hvitis/LanternHouse/docs/prices.csv

offer_id | title | format | grade | thickness_mm | width_mm | length_mm | size_cm | pack_qty | area_sheet_m2 | total_area_m2 | price_pln | price_with_shipping_pln | price_per_sheet_pln | price_per_m2_pln | price_with_shipping_per_m2_pln | rating | reviews_count | bought_count | smart | promoted
1 | SKLEJKA DESKA 3mm FORMATKA DO LASERA CNC GRAWER 300x100mm 1 SZT KLASA 2 | 10x30cm | Klasa 2 | 3.0 | 100 | 300 | 10.0x30.0 | 1 | 0.0300 | 0.0300 | 1.60 | 12.09 | 1.60 | 53.33 | 403.00 | 4.97 | 32 | 11 | Tak | Nie
2 | SKLEJKA DESKA 3mm FORMATKA DO LASERA CNC GRAWER 300x100mm 5 SZT KLASA 2 | 10x30cm | Klasa 2 | 3.0 | 100 | 300 | 10.0x30.0 | 5 | 0.0300 | 0.1500 | 8.02 | 18.51 | 1.60 | 53.47 | 123.40 | 4.97 | 32 | 11 | Tak | Nie
3 | SKLEJKA DESKA 3mm FORMATKA DO LASERA CNC GRAWER 300x100mm 10 SZT KLASA 2 | 10x30cm | Klasa 2 | 3.0 | 100 | 300 | 10.0x30.0 | 10 | 0.0300 | 0.3000 | 16.05 | 26.54 | 1.60 | 53.50 | 88.47 | 4.97 | 32 | 11 | Tak | Nie
4 | SKLEJKA DESKA 3mm FORMATKA DO LASERA CNC GRAWER 300x100mm 20 SZT KLASA 2 | 10x30cm | Klasa 2 | 3.0 | 100 | 300 | 10.0x30.0 | 20 | 0.0300 | 0.6000 | 32.09 | 42.58 | 1.60 | 53.48 | 70.97 | 4.97 | 32 | 11 | Tak | Nie
5 | SKLEJKA DESKA 3mm FORMATKA DO LASERA CNC GRAWER 300x100mm 50 SZT KLASA 2 | 10x30cm | Klasa 2 | 3.0 | 100 | 300 | 10.0x30.0 | 50 | 0.0300 | 1.5000 | 79.70 | 90.19 | 1.59 | 53.13 | 60.13 | 4.97 | 32 | 11 | Tak | Nie
6 | SKLEJKA DESKA A5 3mm FORMATKA DO LASERA CNC GRAWER 148x210mm 1 SZT KLASA 2 | A5 | Klasa 2 | 3.0 | 148 | 210 | 14.8x21.0 | 1 | 0.0311 | 0.0311 | 1.60 | 12.09 | 1.60 | 51.48 | 389.00 | 4.93 | 56 | 28 | Tak | Nie
7 | SKLEJKA DESKA A5 3mm FORMATKA DO LASERA CNC GRAWER 148x210mm 5 SZT KLASA 2 | A5 | Klasa 2 | 3.0 | 148 | 210 | 14.8x21.0 | 5 | 0.0311 | 0.1554 | 8.02 | 18.51 | 1.60 | 51.61 | 119.11 | 4.93 | 112 | 56 | Tak | Nie
8 | SKLEJKA DESKA A5 3mm FORMATKA DO LASERA CNC GRAWER 148x210mm 10 SZT KLASA 2 | A5 | Klasa 2 | 3.0 | 148 | 210 | 14.8x21.0 | 10 | 0.0311 | 0.3108 | 16.04 | 26.53 | 1.60 | 51.61 | 85.36 | 4.93 | 112 | 56 | Tak | Nie
9 | SKLEJKA DESKA A5 3mm FORMATKA DO LASERA CNC GRAWER 148x210mm 20 SZT KLASA 2 | A5 | Klasa 2 | 3.0 | 148 | 210 | 14.8x21.0 | 20 | 0.0311 | 0.6216 | 32.05 | 42.54 | 1.60 | 51.56 | 68.44 | 4.93 | 57 | 31 | Tak | Nie
10 | SKLEJKA DESKA A5 3mm FORMATKA DO LASERA CNC GRAWER 148x210mm 50 SZT KLASA 2 | A5 | Klasa 2 | 3.0 | 148 | 210 | 14.8x21.0 | 50 | 0.0311 | 1.5540 | 79.70 | 90.19 | 1.59 | 51.29 | 58.04 | 4.93 | 112 | 56 | Tak | Nie
11 | SKLEJKA DESKA A4 3mm FORMATKA DO LASERA CNC GRAWER 210x297mm 1 SZT KLASA 1 | A4 | Klasa 1 | 3.0 | 210 | 297 | 21.0x29.7 | 1 | 0.0624 | 0.0624 | 3.21 | 13.70 | 3.21 | 51.47 | 219.66 | 4.73 | 548 | 356 | Tak | Tak
12 | SKLEJKA DESKA A4 3mm FORMATKA DO LASERA CNC GRAWER 210x297mm 5 SZT KLASA 1 | A4 | Klasa 1 | 3.0 | 210 | 297 | 21.0x29.7 | 5 | 0.0624 | 0.3119 | 16.09 | 26.58 | 3.22 | 51.60 | 85.23 | 4.73 | 548 | 356 | Tak | Nie
13 | SKLEJKA DESKA A4 3mm FORMATKA DO LASERA CNC GRAWER 210x297mm 10 SZT KLASA 1 | A4 | Klasa 1 | 3.0 | 210 | 297 | 21.0x29.7 | 10 | 0.0624 | 0.6237 | 32.19 | 42.68 | 3.22 | 51.61 | 68.43 | 4.73 | 548 | 356 | Tak | Nie
14 | SKLEJKA DESKA A4 3mm FORMATKA DO LASERA CNC GRAWER 210x297mm 20 SZT KLASA 1 | A4 | Klasa 1 | 3.0 | 210 | 297 | 21.0x29.7 | 20 | 0.0624 | 1.2474 | 64.39 | 74.88 | 3.22 | 51.62 | 60.03 | 4.73 | 291 | 187 | Tak | Nie
15 | SKLEJKA DESKA A4 3mm FORMATKA DO LASERA CNC GRAWER 210x297mm 50 SZT KLASA 1 | A4 | Klasa 1 | 3.0 | 210 | 297 | 21.0x29.7 | 50 | 0.0624 | 3.1185 | 159.58 | 170.07 | 3.19 | 51.17 | 54.54 | 4.73 | 275 | 184 | Tak | Nie
16 | SKLEJKA DESKA A4 3mm FORMATKA DO LASERA CNC GRAWER 210x297mm 1 SZT KLASA 2 | A4 | Klasa 2 | 3.0 | 210 | 297 | 21.0x29.7 | 1 | 0.0624 | 0.0624 | 3.12 | 13.61 | 3.12 | 50.02 | 218.21 | 4.87 | 106 | 46 | Tak | Tak
17 | SKLEJKA DESKA A4 3mm FORMATKA DO LASERA CNC GRAWER 210x297mm 5 SZT KLASA 2 | A4 | Klasa 2 | 3.0 | 210 | 297 | 21.0x29.7 | 5 | 0.0624 | 0.3119 | 15.62 | 26.11 | 3.12 | 50.09 | 83.73 | 4.86 | 55 | 24 | Tak | Nie
18 | SKLEJKA DESKA A4 3mm FORMATKA DO LASERA CNC GRAWER 210x297mm 10 SZT KLASA 2 | A4 | Klasa 2 | 3.0 | 210 | 297 | 21.0x29.7 | 10 | 0.0624 | 0.6237 | 31.25 | 41.74 | 3.12 | 50.10 | 66.92 | 4.87 | 54 | 28 | Tak | Nie
19 | SKLEJKA DESKA A4 3mm FORMATKA DO LASERA CNC GRAWER 210x297mm 20 SZT KLASA 2 | A4 | Klasa 2 | 3.0 | 210 | 297 | 21.0x29.7 | 20 | 0.0624 | 1.2474 | 62.50 | 72.99 | 3.12 | 50.10 | 58.51 | 4.87 | 54 | 26 | Tak | Nie
20 | SKLEJKA DESKA A4 3mm FORMATKA DO LASERA CNC GRAWER 210x297mm 50 SZT KLASA 2 | A4 | Klasa 2 | 3.0 | 210 | 297 | 21.0x29.7 | 50 | 0.0624 | 3.1185 | 156.27 | 166.76 | 3.13 | 50.11 | 53.47 | 4.87 | 54 | 24 | Tak | Nie
21 | SKLEJKA DESKA 3mm FORMATKA DO LASERA CNC GRAWER 40x30cm KLASA 1 - 1 SZTUKA | 30x40cm | Klasa 1 | 3.0 | 300 | 400 | 30.0x40.0 | 1 | 0.1200 | 0.1200 | 5.97 | 16.46 | 5.97 | 49.75 | 137.17 | 4.65 | 83 | 50 | Tak | Nie
22 | SKLEJKA DESKA 3mm FORMATKA DO LASERA CNC GRAWER 40x30cm KLASA 1 - 5 SZTUK | 30x40cm | Klasa 1 | 3.0 | 300 | 400 | 30.0x40.0 | 5 | 0.1200 | 0.6000 | 29.87 | 40.36 | 5.97 | 49.78 | 67.27 | 4.65 | 83 | 50 | Tak | Nie
23 | SKLEJKA DESKA 3mm FORMATKA DO LASERA CNC GRAWER 40x30cm KLASA 1 - 10 SZTUK | 30x40cm | Klasa 1 | 3.0 | 300 | 400 | 30.0x40.0 | 10 | 0.1200 | 1.2000 | 59.74 | 70.23 | 5.97 | 49.78 | 58.53 | 4.56 | 163 | 122 | Tak | Nie
24 | SKLEJKA DESKA 3mm FORMATKA DO LASERA CNC GRAWER 40x30cm KLASA 1 - 20 SZTUK | 30x40cm | Klasa 1 | 3.0 | 300 | 400 | 30.0x40.0 | 20 | 0.1200 | 2.4000 | 118.65 | 129.14 | 5.93 | 49.44 | 53.81 | 4.65 | 83 | 50 | Tak | Nie
25 | SKLEJKA DESKA 3mm FORMATKA DO LASERA CNC GRAWER 40x30cm KLASA 1 - 50 SZTUK | 30x40cm | Klasa 1 | 3.0 | 300 | 400 | 30.0x40.0 | 50 | 0.1200 | 6.0000 | 294.48 | 304.97 | 5.89 | 49.08 | 50.83 | 4.65 | 83 | 50 | Tak | Nie
26 | SKLEJKA DESKA 3mm FORMATKA DO LASERA CNC GRAWER 40x30cm KLASA 2 - 1 SZTUKA | 30x40cm | Klasa 2 | 3.0 | 300 | 400 | 30.0x40.0 | 1 | 0.1200 | 0.1200 | 5.78 | 16.27 | 5.78 | 48.17 | 135.58 | 4.84 | 25 | 7 | Tak | Nie
27 | SKLEJKA DESKA 3mm FORMATKA DO LASERA CNC GRAWER 40x30cm KLASA 2 - 5 SZTUK | 30x40cm | Klasa 2 | 3.0 | 300 | 400 | 30.0x40.0 | 5 | 0.1200 | 0.6000 | 28.48 | 38.97 | 5.70 | 47.47 | 64.95 | 4.84 | 25 | 7 | Tak | Nie
28 | SKLEJKA DESKA 3mm FORMATKA DO LASERA CNC GRAWER 40x30cm KLASA 2 - 10 SZTUK | 30x40cm | Klasa 2 | 3.0 | 300 | 400 | 30.0x40.0 | 10 | 0.1200 | 1.2000 | 56.90 | 67.39 | 5.69 | 47.42 | 56.16 | 4.84 | 25 | 7 | Tak | Nie
29 | SKLEJKA DESKA 3mm FORMATKA DO LASERA CNC GRAWER 40x30cm KLASA 2 - 20 SZTUK | 30x40cm | Klasa 2 | 3.0 | 300 | 400 | 30.0x40.0 | 20 | 0.1200 | 2.4000 | 109.15 | 119.64 | 5.46 | 45.48 | 49.85 | 4.84 | 25 | 7 | Tak | Nie
30 | SKLEJKA DESKA 3mm FORMATKA DO LASERA CNC GRAWER 40x30cm KLASA 2 - 50 SZTUK | 30x40cm | Klasa 2 | 3.0 | 300 | 400 | 30.0x40.0 | 50 | 0.1200 | 6.0000 | 275.49 | 285.98 | 5.51 | 45.91 | 47.66 | 4.84 | 25 | 7 | Tak | Nie
31 | SKLEJKA DESKA 3mm FORMATKA DO LASERA CNC GRAWER 30x50cm KLASA 1 - 1 SZTUKA | 30x50cm | Klasa 1 | 3.0 | 300 | 500 | 30.0x50.0 | 1 | 0.1500 | 0.1500 | 7.30 | 17.79 | 7.30 | 48.67 | 118.60 | 4.85 | 33 | 29 | Tak | Nie
32 | SKLEJKA DESKA 3mm FORMATKA DO LASERA CNC GRAWER 30x50cm KLASA 1 - 5 SZTUK | 30x50cm | Klasa 1 | 3.0 | 300 | 500 | 30.0x50.0 | 5 | 0.1500 | 0.7500 | 36.52 | 47.01 | 7.30 | 48.69 | 62.68 | 4.85 | 33 | 29 | Tak | Nie
33 | SKLEJKA DESKA 3mm FORMATKA DO LASERA CNC GRAWER 30x50cm KLASA 1 - 10 SZTUK | 30x50cm | Klasa 1 | 3.0 | 300 | 500 | 30.0x50.0 | 10 | 0.1500 | 1.5000 | 73.04 | 83.53 | 7.30 | 48.69 | 55.69 | 4.85 | 33 | 29 | Tak | Nie
34 | SKLEJKA DESKA 3mm FORMATKA DO LASERA CNC GRAWER 30x50cm KLASA 1 - 20 SZTUK | 30x50cm | Klasa 1 | 3.0 | 300 | 500 | 30.0x50.0 | 20 | 0.1500 | 3.0000 | 145.25 | 155.74 | 7.26 | 48.42 | 51.91 | 4.81 | 32 | 28 | Tak | Nie
35 | SKLEJKA DESKA 3mm FORMATKA DO LASERA CNC GRAWER 30x50cm KLASA 1 - 50 SZTUK | 30x50cm | Klasa 1 | 3.0 | 300 | 500 | 30.0x50.0 | 50 | 0.1500 | 7.5000 | 364.79 | 375.28 | 7.30 | 48.64 | 50.04 | 4.83 | 30 | 25 | Tak | Nie
36 | SKLEJKA DESKA 3mm FORMATKA DO LASERA CNC GRAWER 30x50cm KLASA 2 - 1 SZTUKA | 30x50cm | Klasa 2 | 3.0 | 300 | 500 | 30.0x50.0 | 1 | 0.1500 | 0.1500 | 7.20 | 17.69 | 7.20 | 48.00 | 117.93 | 5.00 | 9 | 2 | Tak | Nie
37 | SKLEJKA DESKA 3mm FORMATKA DO LASERA CNC GRAWER 30x50cm KLASA 2 - 5 SZTUK | 30x50cm | Klasa 2 | 3.0 | 300 | 500 | 30.0x50.0 | 5 | 0.1500 | 0.7500 | 36.04 | 46.53 | 7.21 | 48.05 | 62.04 | 5.00 | 9 | 2 | Tak | Nie
38 | SKLEJKA DESKA 3mm FORMATKA DO LASERA CNC GRAWER 30x50cm KLASA 2 - 10 SZTUK | 30x50cm | Klasa 2 | 3.0 | 300 | 500 | 30.0x50.0 | 10 | 0.1500 | 1.5000 | 72.09 | 82.58 | 7.21 | 48.06 | 55.05 | 5.00 | 9 | 2 | Tak | Nie
39 | SKLEJKA DESKA 3mm FORMATKA DO LASERA CNC GRAWER 30x50cm KLASA 2 - 20 SZTUK | 30x50cm | Klasa 2 | 3.0 | 300 | 500 | 30.0x50.0 | 20 | 0.1500 | 3.0000 | 142.48 | 152.97 | 7.12 | 47.49 | 50.99 | 5.00 | 9 | 2 | Tak | Nie
40 | SKLEJKA DESKA 3mm FORMATKA DO LASERA CNC GRAWER 30x50cm KLASA 2 - 50 SZTUK | 30x50cm | Klasa 2 | 3.0 | 300 | 500 | 30.0x50.0 | 50 | 0.1500 | 7.5000 | 350.54 | 361.03 | 7.01 | 46.74 | 48.14 | 5.00 | 9 | 2 | Tak | Nie
41 | SKLEJKA 3mm FORMATKA DO LASERA CNC GRAWER 30x60cm 300x600mm KLASA 1 1 SZT | 30x60cm | Klasa 1 | 3.0 | 300 | 600 | 30.0x60.0 | 1 | 0.1800 | 0.1800 | 8.91 | 19.40 | 8.91 | 49.50 | 107.78 | 4.95 | 44 | 52 | Tak | Nie
42 | SKLEJKA DESKA 3mm FORMATKA DO LASERA CNC GRAWER 30x60cm KLASA 1 - 5 SZTUK | 30x60cm | Klasa 1 | 3.0 | 300 | 600 | 30.0x60.0 | 5 | 0.1800 | 0.9000 | 47.41 | 57.90 | 9.48 | 52.68 | 64.33 | 4.80 | 25 | 26 | Tak | Nie
43 | SKLEJKA DESKA 3mm FORMATKA DO LASERA CNC GRAWER 30x60cm KLASA 1 - 10 SZTUK | 30x60cm | Klasa 1 | 3.0 | 300 | 600 | 30.0x60.0 | 10 | 0.1800 | 1.8000 | 89.19 | 99.68 | 8.92 | 49.55 | 55.38 | 4.89 | 27 | 29 | Tak | Nie
44 | SKLEJKA DESKA 3mm FORMATKA DO LASERA CNC GRAWER 30x60cm KLASA 1 - 20 SZTUK | 30x60cm | Klasa 1 | 3.0 | 300 | 600 | 30.0x60.0 | 20 | 0.1800 | 3.6000 | 178.11 | 188.60 | 8.91 | 49.48 | 52.39 | 4.95 | 22 | 28 | Tak | Nie
45 | SKLEJKA DESKA 3mm FORMATKA DO LASERA CNC GRAWER 30x60cm KLASA 1 - 50 SZTUK | 30x60cm | Klasa 1 | 3.0 | 300 | 600 | 30.0x60.0 | 50 | 0.1800 | 9.0000 | 436.04 | 446.53 | 8.72 | 48.45 | 49.61 | 4.95 | 22 | 26 | Tak | Nie
46 | SKLEJKA DESKA 3mm FORMATKA DO LASERA CNC GRAWER 30x60cm KLASA 2 - 1 SZTUKA | 30x60cm | Klasa 2 | 3.0 | 300 | 600 | 30.0x60.0 | 1 | 0.1800 | 0.1800 | 8.68 | 19.17 | 8.68 | 48.22 | 106.50 | 5.00 | 7 | 2 | Tak | Nie
47 | SKLEJKA DESKA 3mm FORMATKA DO LASERA CNC GRAWER 30x60cm KLASA 2 - 5 SZTUK | 30x60cm | Klasa 2 | 3.0 | 300 | 600 | 30.0x60.0 | 5 | 0.1800 | 0.9000 | 47.41 | 57.90 | 9.48 | 52.68 | 64.33 | 5.00 | 7 | 2 | Tak | Nie
48 | SKLEJKA DESKA 3mm FORMATKA DO LASERA CNC GRAWER 30x60cm KLASA 2 - 10 SZTUK | 30x60cm | Klasa 2 | 3.0 | 300 | 600 | 30.0x60.0 | 10 | 0.1800 | 1.8000 | 86.91 | 97.40 | 8.69 | 48.28 | 54.11 | 5.00 | 7 | 2 | Tak | Nie
49 | SKLEJKA DESKA 3mm FORMATKA DO LASERA CNC GRAWER 30x60cm KLASA 2 - 20 SZTUK | 30x60cm | Klasa 2 | 3.0 | 300 | 600 | 30.0x60.0 | 20 | 0.1800 | 3.6000 | 170.98 | 181.47 | 8.55 | 47.49 | 50.41 | 5.00 | 7 | 1 | Tak | Nie
50 | SKLEJKA DESKA 3mm FORMATKA DO LASERA CNC GRAWER 30x60cm KLASA 2 - 50 SZTUK | 30x60cm | Klasa 2 | 3.0 | 300 | 600 | 30.0x60.0 | 50 | 0.1800 | 9.0000 | 417.04 | 427.53 | 8.34 | 46.34 | 47.50 | 5.00 | 7 | 2 | Tak | Nie
51 | SKLEJKA DESKA 3mm FORMATKA DO LASERA CNC GRAWER 600x400mm KLASA 1 -1 SZTUKA | 40x60cm | Klasa 1 | 3.0 | 400 | 600 | 40.0x60.0 | 1 | 0.2400 | 0.2400 | 13.76 | 24.25 | 13.76 | 57.33 | 101.04 | 4.53 | 144 | 54 | Tak | Nie
52 | SKLEJKA DESKA 3mm FORMATKA DO LASERA CNC GRAWER 600x400mm KLASA 1 - 5 SZTUK | 40x60cm | Klasa 1 | 3.0 | 400 | 600 | 40.0x60.0 | 5 | 0.2400 | 1.2000 | 68.82 | 79.31 | 13.76 | 57.35 | 66.09 | 4.53 | 76 | 31 | Tak | Nie
53 | SKLEJKA DESKA 3mm FORMATKA DO LASERA CNC GRAWER 600x400mm KLASA 1 -10 SZTUK | 40x60cm | Klasa 1 | 3.0 | 400 | 600 | 40.0x60.0 | 10 | 0.2400 | 2.4000 | 137.65 | 148.14 | 13.77 | 57.35 | 61.72 | 4.51 | 77 | 33 | Tak | Nie
54 | SKLEJKA DESKA 3mm FORMATKA DO LASERA CNC GRAWER 600x400mm KLASA 1 -20 SZTUK | 40x60cm | Klasa 1 | 3.0 | 400 | 600 | 40.0x60.0 | 20 | 0.2400 | 4.8000 | 275.40 | 285.89 | 13.77 | 57.38 | 59.56 | 4.53 | 74 | 31 | Tak | Nie
55 | SKLEJKA DESKA 3mm FORMATKA DO LASERA CNC GRAWER 600x400mm KLASA 1 -50 SZTUK | 40x60cm | Klasa 1 | 3.0 | 400 | 600 | 40.0x60.0 | 50 | 0.2400 | 12.0000 | 683.90 | 698.89 | 13.68 | 56.99 | 58.24 | 4.53 | 72 | 28 | Tak | Nie
56 | SKLEJKA 3mm FORMATKA DO LASERA CNC GRAWER 60x40cm 600x400mm KLASA 2 - 1 SZT | 40x60cm | Klasa 2 | 3.0 | 400 | 600 | 40.0x60.0 | 1 | 0.2400 | 0.2400 | 13.56 | 24.05 | 13.56 | 56.50 | 100.21 | 4.74 | 154 | 20 | Tak | Tak
57 | SKLEJKA 3mm FORMATKA DO LASERA CNC GRAWER 60x40cm 600x400mm KLASA 2 - 5 SZT | 40x60cm | Klasa 2 | 3.0 | 400 | 600 | 40.0x60.0 | 5 | 0.2400 | 1.2000 | 66.48 | 76.97 | 13.30 | 55.40 | 64.14 | 4.75 | 79 | 11 | Tak | Nie
58 | SKLEJKA 3mm FORMATKA DO LASERA CNC GRAWER 60x40cm 600x400mm KLASA 2 -10 SZT | 40x60cm | Klasa 2 | 3.0 | 400 | 600 | 40.0x60.0 | 10 | 0.2400 | 2.4000 | 132.98 | 143.47 | 13.30 | 55.41 | 59.78 | 4.75 | 81 | 11 | Tak | Nie
59 | SKLEJKA 3mm FORMATKA DO LASERA CNC GRAWER 60x40cm 600x400mm KLASA 2 -20 SZT | 40x60cm | Klasa 2 | 3.0 | 400 | 600 | 40.0x60.0 | 20 | 0.2400 | 4.8000 | 264.99 | 275.48 | 13.25 | 55.21 | 57.39 | 4.74 | 77 | 10 | Tak | Nie
60 | SKLEJKA 3mm FORMATKA DO LASERA CNC GRAWER 60x40cm 600x400mm KLASA 2 -50 SZT | 40x60cm | Klasa 2 | 3.0 | 400 | 600 | 40.0x60.0 | 50 | 0.2400 | 12.0000 | 664.04 | 679.03 | 13.28 | 55.34 | 56.59 | 4.74 | 77 | 11 | Tak | Nie
61 | SKLEJKA DESKA 3mm FORMATKA DO LASERA CNC GRAWER 50x50cm KLASA 1 - 1 SZTUKA | 50x50cm | Klasa 1 | 3.0 | 500 | 500 | 50.0x50.0 | 1 | 0.2500 | 0.2500 | 12.33 | 27.32 | 12.33 | 49.32 | 109.28 | 4.67 | 30 | 8 | Tak | Nie
62 | SKLEJKA DESKA 3mm FORMATKA DO LASERA CNC GRAWER 50x50cm KLASA 1 - 5 SZTUK | 50x50cm | Klasa 1 | 3.0 | 500 | 500 | 50.0x50.0 | 5 | 0.2500 | 1.2500 | 61.75 | 76.74 | 12.35 | 49.40 | 61.39 | 4.67 | 30 | 8 | Tak | Nie
63 | SKLEJKA DESKA 3mm FORMATKA DO LASERA CNC GRAWER 50x50cm KLASA 1 - 10 SZTUK | 50x50cm | Klasa 1 | 3.0 | 500 | 500 | 50.0x50.0 | 10 | 0.2500 | 2.5000 | 122.53 | 137.52 | 12.25 | 49.01 | 55.01 | 4.67 | 30 | 8 | Tak | Nie
64 | SKLEJKA DESKA 3mm FORMATKA DO LASERA CNC GRAWER 50x50cm KLASA 2 - 1 SZTUKA | 50x50cm | Klasa 2 | 3.0 | 500 | 500 | 50.0x50.0 | 1 | 0.2500 | 0.2500 | 11.95 | 26.94 | 11.95 | 47.80 | 107.76 | 4.77 | 26 | 8 | Tak | Nie
65 | SKLEJKA DESKA 3mm FORMATKA DO LASERA CNC GRAWER 50x50cm KLASA 2 - 5 SZTUK | 50x50cm | Klasa 2 | 3.0 | 500 | 500 | 50.0x50.0 | 5 | 0.2500 | 1.2500 | 59.79 | 74.78 | 11.96 | 47.83 | 59.82 | 4.77 | 26 | 8 | Tak | Nie
66 | SKLEJKA DESKA 3mm FORMATKA DO LASERA CNC GRAWER 50x50cm KLASA 2 - 10 SZTUK | 50x50cm | Klasa 2 | 3.0 | 500 | 500 | 50.0x50.0 | 10 | 0.2500 | 2.5000 | 119.49 | 134.48 | 11.95 | 47.80 | 53.79 | 4.77 | 26 | 8 | Tak | Nie
67 | SKLEJKA DESKA 3mm FORMATKA DO LASERA CNC GRAWER 50x50cm KLASA 2 - 20 SZTUK | 50x50cm | Klasa 2 | 3.0 | 500 | 500 | 50.0x50.0 | 20 | 0.2500 | 5.0000 | 237.48 | 252.47 | 11.87 | 47.50 | 50.49 | 4.77 | 26 | 8 | Tak | Nie
68 | SKLEJKA DESKA 3mm FORMATKA DO LASERA CNC GRAWER 50x50cm KLASA 2 - 50 SZTUK | 50x50cm | Klasa 2 | 3.0 | 500 | 500 | 50.0x50.0 | 50 | 0.2500 | 12.5000 | 588.04 | 603.03 | 11.76 | 47.04 | 48.24 | 4.77 | 26 | 8 | Tak | Nie
69 | SKLEJKA DESKA 3mm FORMATKA DO LASERA CNC GRAWER 760x380mm 1 SZTUKA KLASA 2 | 38x76cm | Klasa 2 | 3.0 | 380 | 760 | 38.0x76.0 | 1 | 0.2888 | 0.2888 | 13.28 | 28.27 | 13.28 | 45.98 | 97.89 | 5.00 | 2 | 1 | Tak | Nie
70 | SKLEJKA DESKA 3mm FORMATKA DO LASERA CNC GRAWER 760x380mm 5 SZTUK KLASA 2 | 38x76cm | Klasa 2 | 3.0 | 380 | 760 | 38.0x76.0 | 5 | 0.2888 | 1.4440 | 66.44 | 80.93 | 13.29 | 46.01 | 56.05 | 5.00 | 2 | 1 | Tak | Nie
71 | SKLEJKA DESKA 3mm FORMATKA DO LASERA CNC GRAWER 760x380mm 10 SZTUK KLASA 2 | 38x76cm | Klasa 2 | 3.0 | 380 | 760 | 38.0x76.0 | 10 | 0.2888 | 2.8880 | 132.90 | 147.89 | 13.29 | 46.02 | 51.21 | 5.00 | 2 | 1 | Tak | Nie
72 | SKLEJKA DESKA 3mm FORMATKA DO LASERA CNC GRAWER 760x380mm 20 SZTUK KLASA 2 | 38x76cm | Klasa 2 | 3.0 | 380 | 760 | 38.0x76.0 | 20 | 0.2888 | 5.7760 | 265.79 | 280.78 | 13.29 | 46.02 | 48.61 | 5.00 | 2 | 1 | Tak | Nie
73 | SKLEJKA DESKA 3mm FORMATKA DO LASERA CNC GRAWER 760x760mm 1 SZTUKA KLASA 2 | 76x76cm | Klasa 2 | 3.0 | 760 | 760 | 76.0x76.0 | 1 | 0.5776 | 0.5776 | 26.58 | 41.57 | 26.58 | 46.02 | 71.97 | 5.00 | 4 | 1 | Tak | Nie
74 | SKLEJKA DESKA 3mm FORMATKA DO LASERA CNC GRAWER 760x760mm 5 SZTUK KLASA 2 | 76x76cm | Klasa 2 | 3.0 | 760 | 760 | 76.0x76.0 | 5 | 0.5776 | 2.8880 | 132.94 | 147.93 | 26.59 | 46.03 | 51.22 | 5.00 | 4 | 1 | Tak | Nie
75 | SKLEJKA DESKA 3mm FORMATKA DO LASERA CNC GRAWER 760x760mm 10 SZTUK KLASA 2 | 76x76cm | Klasa 2 | 3.0 | 760 | 760 | 76.0x76.0 | 10 | 0.5776 | 5.7760 | 265.80 | 280.79 | 26.58 | 46.02 | 48.61 | 5.00 | 4 | 1 | Tak | Nie
