hvitis/LanternHouse/prints/table.step

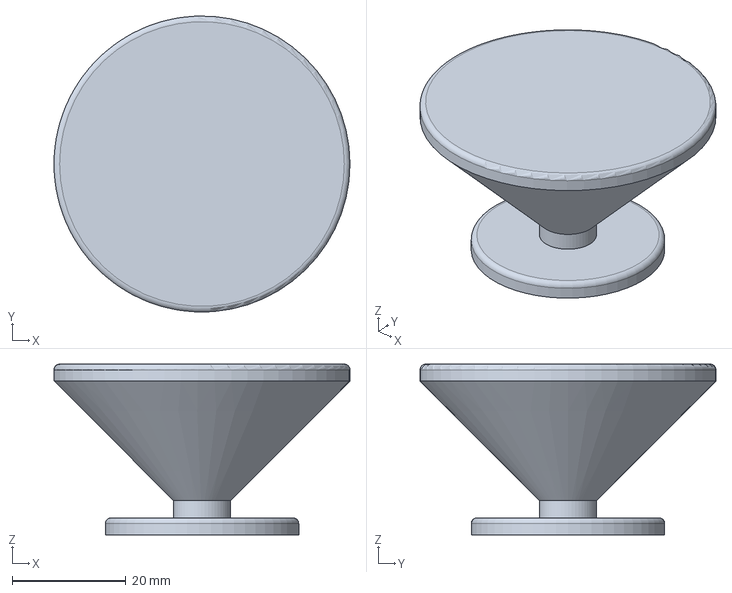
[picture p7: CAD file, 2026-10-16]
prints/table.step
52.0 x 52.0 x 30.0 mm
