hvitis/LanternHouse/prints/bathtub.step

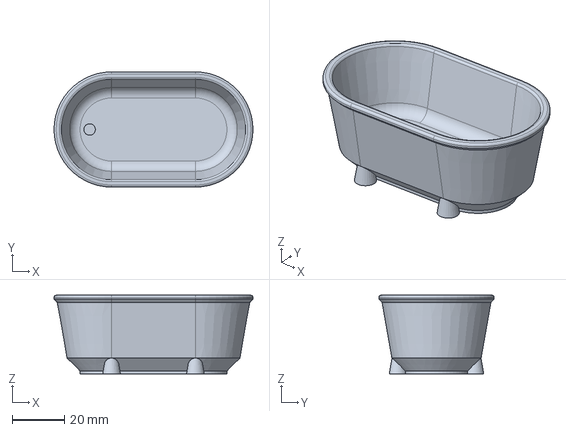
[picture p8: CAD file, 2026-10-16]
prints/bathtub.step
76.0 x 44.0 x 30.0 mm
