hvitis/LanternHouse/prints/chandelier.step

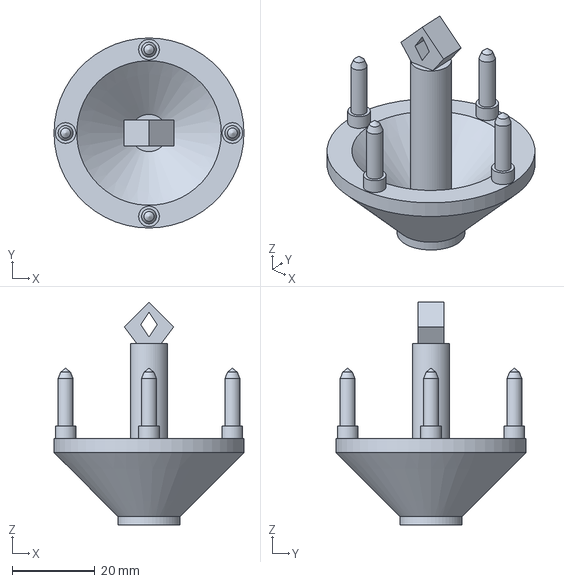
[picture p9: CAD file, 2026-10-16]
prints/chandelier.step
46.0 x 46.0 x 54.0 mm
