hvitis/LanternHouse/prints/chair.step

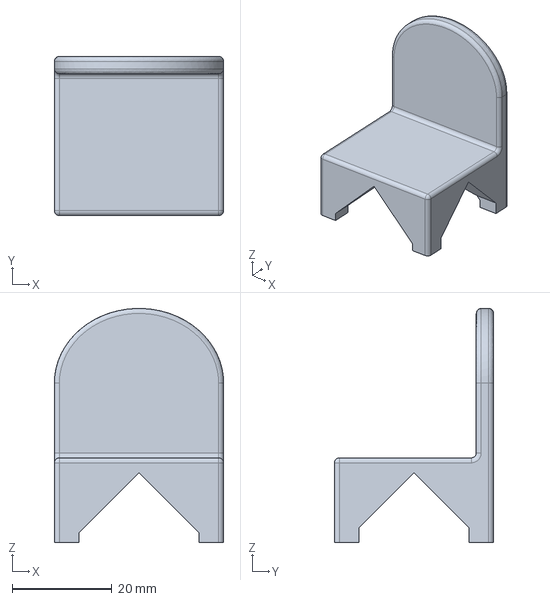
[picture p10: CAD file, 2026-10-16]
prints/chair.step
34.0 x 32.0 x 47.0 mm
