hvitis/LanternHouse/prints/stove.step

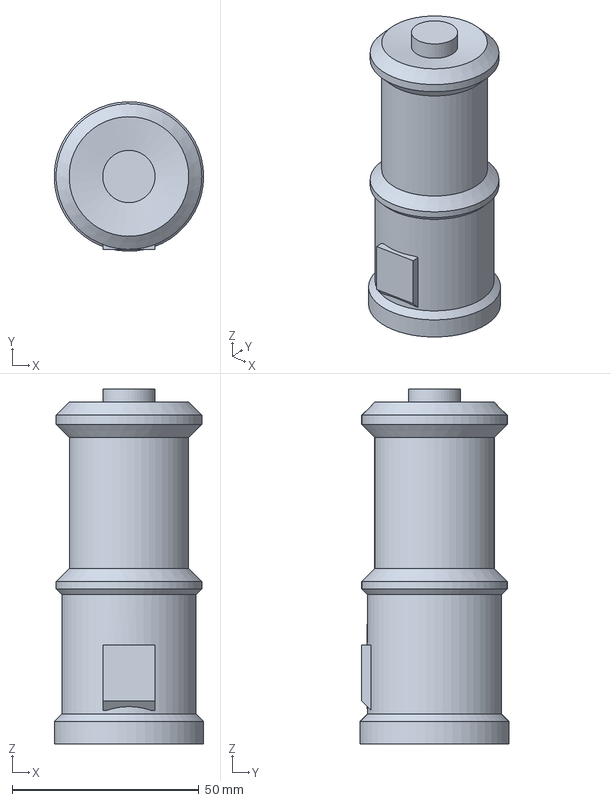
[picture p11: CAD file, 2026-10-16]
prints/stove.step
40.0 x 40.0 x 95.0 mm
