hvitis/LanternHouse/(list of files, cad)

Other CAD files:
prints/bathtub.3mf
prints/bathtub.stl
prints/chair.3mf
prints/chair.stl
prints/chandelier.3mf
prints/chandelier.stl
prints/stove.3mf
prints/stove.stl
prints/table.3mf
prints/table.stl
