hvitis/LanternHouse/(commit log)

2026-10-15 feat: new assessment price algorithm, new output format, print space optimisation, dxf export
    [chair.3mf, chair.step, chair.stl, table.3mf, table.step, table.stl]
2026-10-15 fix(ci): add missing supplier profile, price data, and handle empty asset globs in release
    [prices.csv]
2026-10-15 feat: printables preview
    [bathtub.3mf, bathtub.step, bathtub.stl, chair.step, chandelier.3mf, chandelier.step, chandelier.stl, stove.3mf]
2026-10-16 feat: name change
    [bathtub.step, chair.step, chandelier.step, stove.step, table.step]
